donnersm/BluetoothAnalyzer/Arduino Code/instruction.txt

Make sure that all files are in the same directory!
