donnersm/BluetoothAnalyzer/hardware/matrix layout.png

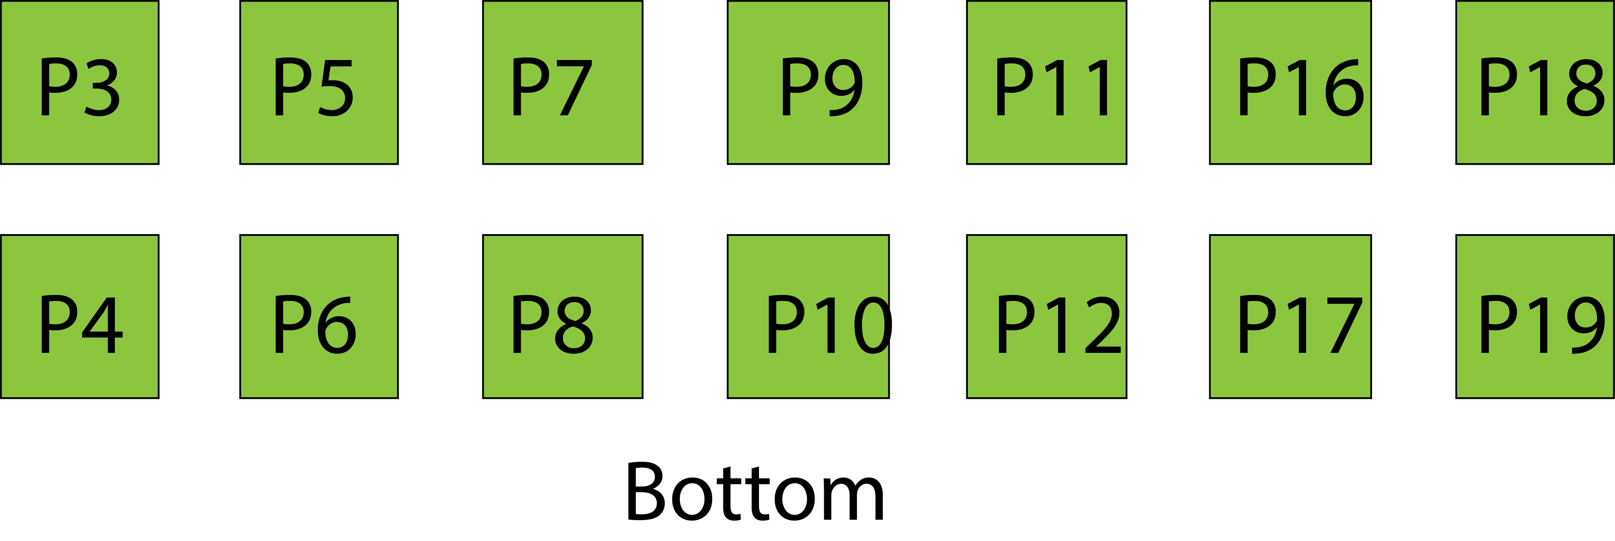
hardware/matrix layout.png
