donnersm/BluetoothAnalyzer/hardware/BOM_3584LEDPANEL_2024-05-17.csv

ID | Name | Designator | Footprint | Quantity | Manufacturer Part | Manufacturer | Supplier | Supplier Part | Price
1 | PCM5102_AUDIO_BOARD | U1 | PCM5102 AUDIO PCB | 0 | Do not assemble | WCMCU |  | PCM5102A | Do not assemble
2 | 22041031 | P12,P2,P3,P4,P5,P6,P7,P8,P9,P10,P11,P16,P17,P18,P19 | CONN-TH_3P-P2.54_22041031 | 15 | 22041031 | MOLEX | LCSC | C293437 | 0.097
3 | 300 | R19,R5,R6,R8,R9,R10,R11,R12,R13,R14,R15,R16,R17,R18 | R0805 | 14 | 0805W8F3000T5E | UNI-ROYAL(厚声) | LCSC | C17617 | 0.002
4 | KF8500-4P-8.4MM | CN1 | CONN-TH_KF8500-4P-8.4MM | 1 | KF8500-4P-8.4mm | BOOMELE(博穆精密) | LCSC | C24671 | 0.2
5 | 100uF | C1,C2,C3,C4,C5,C6,C7,C8,C9,C10,C11,C12,C13,C14 | CAP-SMD_BD6.3-L6.6-W6.6-FD | 14 | RST100UF16V003 | KNSCHA(科尼盛) | LCSC | C4747963 | 0.025
6 | Fuse Socket TR5 | FH1,FH2,FH3,FH4,FH5,FH6,FH7,FH8,FH9,FH10,FH11,FH12,FH13,FH14 | FUSE-TH_BD9.5-P5.08-D1.0 | 14 | 56000001009 | Littelfuse | LCSC | C142909 | 0.487
6B | Fuse to fit in socket from line 6 |  |  | 14 | 37212000001 | Littelfuse | LCSC | C142854 | 0.143
7 | 1715734 | P1 | CONN-TH_3P-P5.08_1715734 | 1 | 1715734 | Phoenix Contact | LCSC | C480520 | 0.555
8 | Header-Male-2.54_1x1 | P13,P14,P15,P20 | Do not assemble | 0 | Do not assemble | ReliaPro | LCSC | Do not assemble | Do not assemble
9 | Resistor 10E 0805 | R1 | R0805_NEW | 1 | 0805W8F100JT5E | UNI-ROYAL(厚声) | LCSC | C17415 | 0.002
10 | Potmeter 10K | R2,R3,R4 | RES-TH_RK09D1130C2P | 3 | RK09D1130C2P | ALPS Electric | LCSC | C361173 | 0.583
11 | Resistor 0805 10kΩ | R7 | R0805 | 1 | 0805W8F1002T5E | UNI-ROYAL(厚声) | LCSC | C17414 | 0.002
12 | TC-1102-C-J-B | SW1 | KEY-TH_4P-L6.0-W6.0-P4.50-LS6.5 | 1 | TC-1102-C-Y-B | XKB Enterprise | LCSC | C2885075 | 0.048
13 | ESP32 DEVKIT V1 666 | U4 | DOIT-ESP32-DEVKIT-V1 | 0 |  |  |  |  | Do not assemble
14 | 22041061 | U3 | CONN-TH_22041061 | 1 | 22041061 | MOLEX | LCSC | C293438 | 0.134
15 | 22057068 | U2 | CONN-TH_6P-P2.54_MOLEX_22057068 | 1 | 22057068 | MOLEX | LCSC | C587001 | 0.542
