donnersm/BluetoothAnalyzer/hardware/PCB_PCB_3584LEDPANEL_2024-09-20.pdf

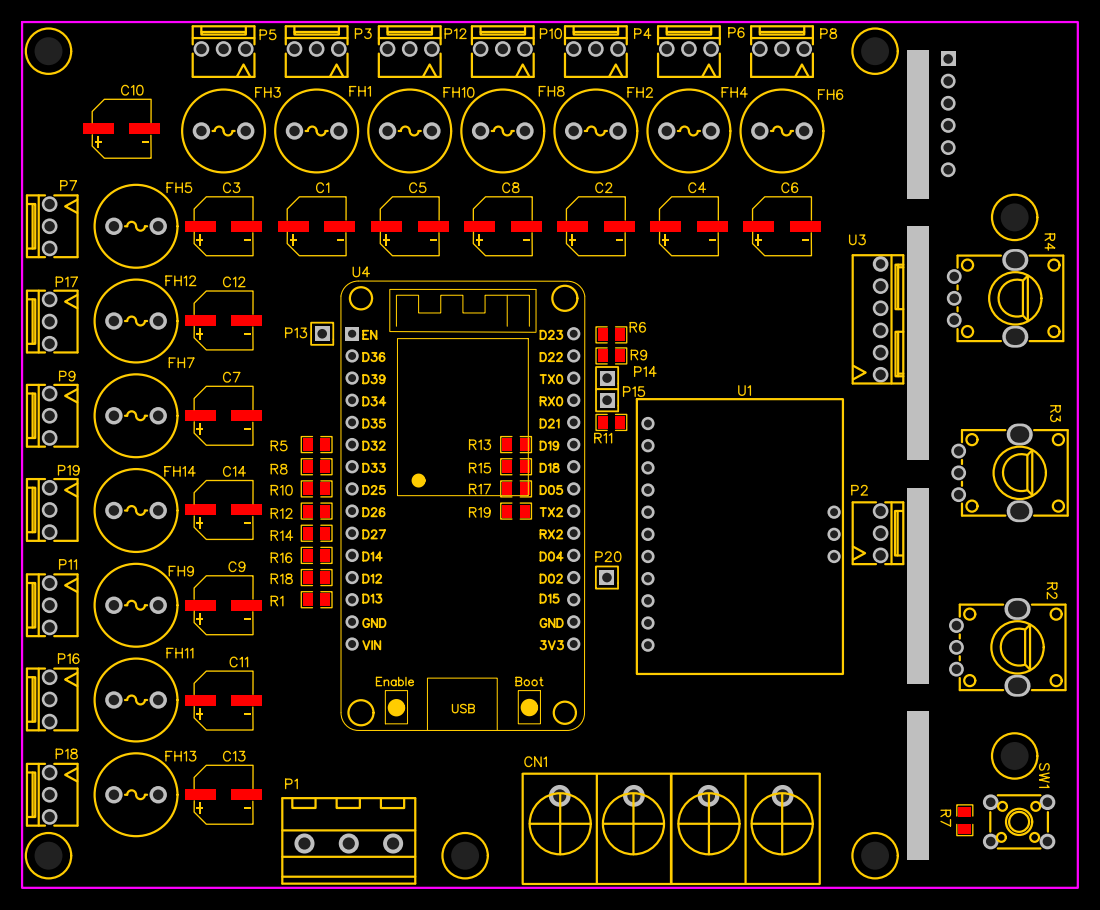
[picture p2: page 1]
