donnersm/BluetoothAnalyzer/hardware/Schematic_3584LEDPANEL_2024-09-19.pdf

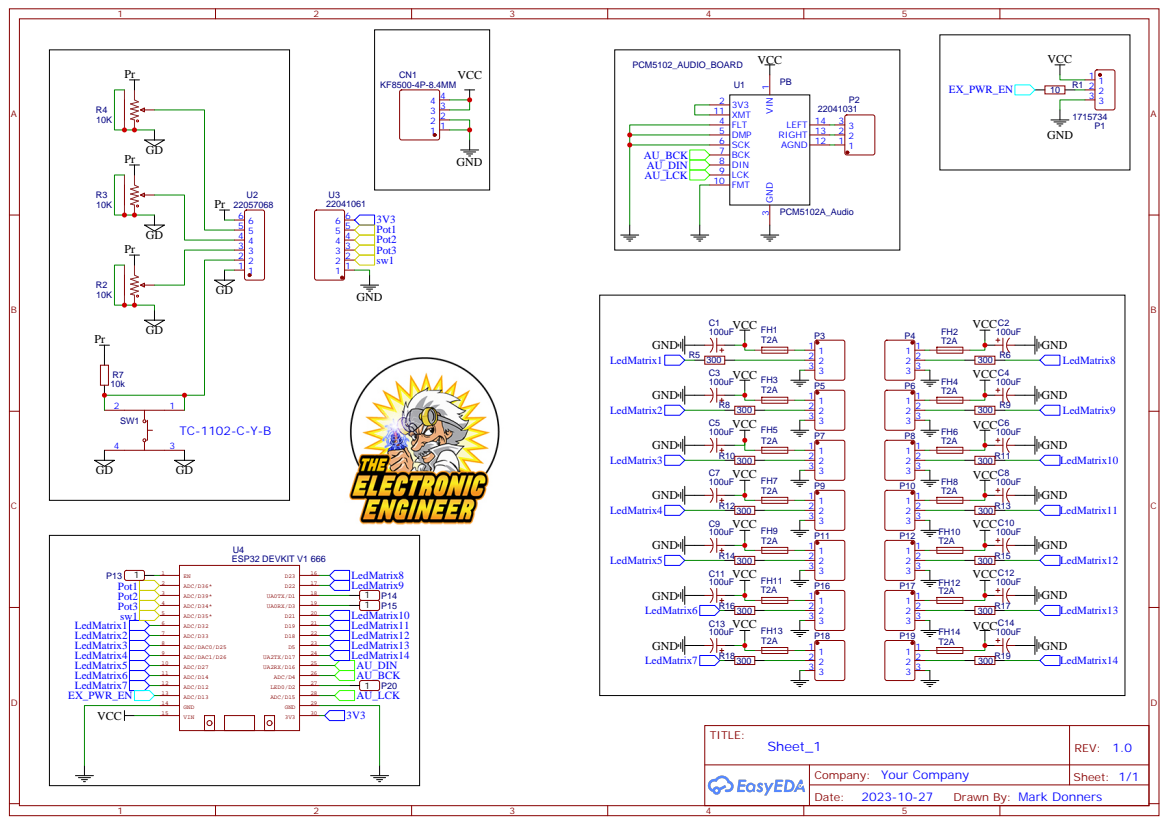
[picture p3: page 1]

Drawn By: Mark Donners
