donnersm/BluetoothAnalyzer/(threads)

Thread 1 (2024-11-04):

Amazing sketch, thanks for sharing. Adding esp-dsp support for hardware accerated FFTs?

mrcodetastic, 2024-11-04:
Hello. I noticed this project and look forward to trying it out on an ESP32S3 and using an LED matrix instead.

I just wanted to inform you that the ESP32-S3 has additional DSP related CPU SIMD instructions that coud materially improve the FFT throughput. As such, I was wondering if you ever had plans to assess the esp32-dsp library and see if this project works even better when using a S3 SoC.

donnersm, 2024-11-04:
I wasn’t planning on it. But who knows…. Might do that in the future.

mrcodetastic, 2024-11-05:
Ok cool. I might give it a crack then!

Closed 2024-11-04.
